DeemanthaGunasekara/Kickbots-Arena/Final set up/Poster/ITM_12_Ohmies.png

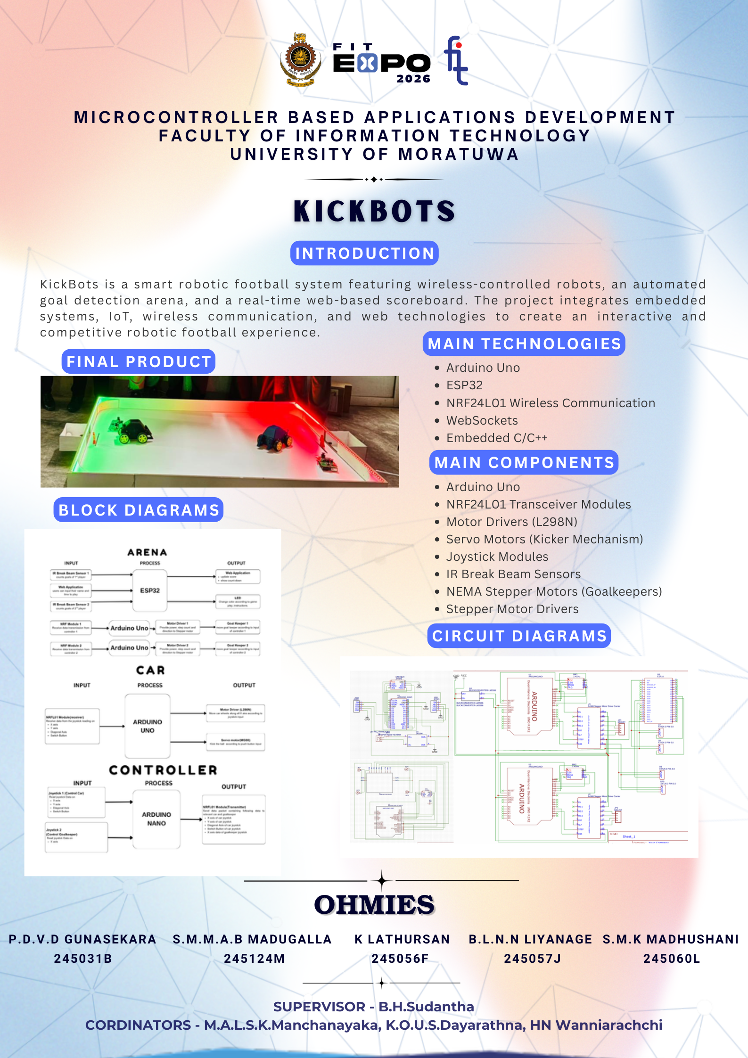
Final set up/Poster/ITM_12_Ohmies.png
