DeemanthaGunasekara/Kickbots-Arena/Screenshot 2025-11-11 154036.png

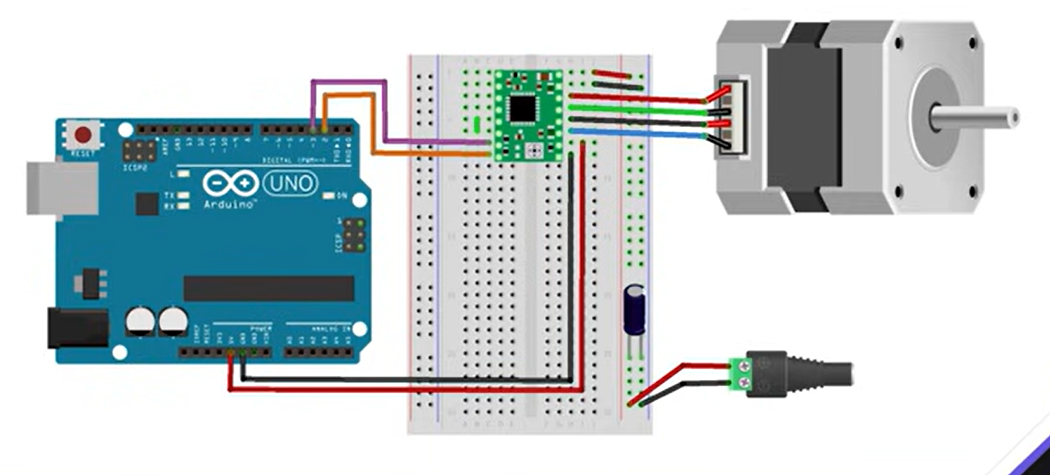
Screenshot 2025-11-11 154036.png
