DeemanthaGunasekara/Kickbots-Arena/README.md

# ⚽ KickBots – Football Robot System

## 📌 Project Description

**KickBots** is a robotics project that combines embedded systems, wireless communication, web technologies, and mechanical design to create a robotic football system. It features two remotely controlled robot cars, a wireless controller, and a smart football arena with automated goal detection and visual and audio feedback.

The robots use Arduino Uno microcontrollers and NRF24L01 wireless modules for communication, while an ESP32 powers the arena's web-based control interface and manages goal detection using IR sensors. LED strips and a buzzer provide feedback when a goal is scored, and a stepper motor-based mechanism supports the goalkeeper system.

The project integrates hardware and software to demonstrate real-time control, wireless communication, and automation in an interactive robotic football environment.

## ✨ Key Features

- 🤖 Two remotely controlled football robots
- 📡 NRF24L01 wireless communication
- 🎮 Joystick-based robot control
- ⚡ Integrated kicker mechanisms
- 🥅 Automated goal detection using IR sensors
- 💡 LED-based goal indicators
- 🔊 Audio feedback using a buzzer
- 🌐 ESP32-powered web interface
- ⚙️ Stepper motor-based goalkeeper mechanism

## 🛠️ Technologies & Components

### Hardware
- Arduino Uno
- ESP32
- Arduino Nano
- NRF24L01 wireless modules
- DC geared motors and motor drivers
- Joystick modules and push buttons
- IR break-beam sensors
- LED strips and piezo buzzer
- Stepper motor and driver
- Battery packs and voltage regulators

### Software & Technologies
- **C/C++** – Microcontroller programming
- **Arduino IDE** – Embedded development
- **HTML, CSS, JavaScript** – Web interface
- **ESP32 Web Server** – Hosting the arena interface
- **Wireless communication** – NRF24L01 modules

## ⚙️ System Overview

1. **Robot Cars:** Arduino Uno boards control the movement and kicker mechanisms of the robots.
2. **Wireless Controller:** Joysticks and buttons send control commands wirelessly through NRF24L01 modules.
3. **Football Arena:** An ESP32 reads IR sensors to detect goals and activates LED strips and a buzzer.
4. **Web Interface:** The ESP32 hosts a website accessible over a local Wi-Fi network for arena monitoring and control.
5. **Goalkeeper Mechanism:** A stepper motor-based system provides goalkeeper movement.

## 🎯 Project Objectives

- Develop remotely controlled football robots.
- Implement reliable wireless communication between the controller and robots.
- Automate goal detection and arena feedback.
- Integrate embedded hardware with a web-based interface.
- Demonstrate practical applications of robotics, IoT, and embedded systems.
- Real-time score tracking and Led changes.

## 🚀 Future Improvements

- Improve wireless communication range and reliability.
- Enhance robot movement and control responsiveness.
- Improve the web interface with additional monitoring features.
- Optimize battery life and power management.
