DeemanthaGunasekara/Kickbots-Arena/Final set up/Proud to share the completion of our IoT.docx

Proud to share the completion of our IoT/Embedded Systems project — KickBots ⚽🤖

KickBots is a wireless embedded robotics system consisting of two Arduino-based football robots, a handheld controller unit, and an arena subsystem for automated goal detection. The robots are controlled in real time using NRF24L01 wireless modules, enabling low-latency communication between the controller and the robots, while IR sensor-based detection is used in the arena to identify goals and trigger scoring events.

The system was developed by a team of 5 members as part of our Information Technology and Management (ITM) degree at the University of Moratuwa. The initial concept and system idea were initiated by me and further developed collaboratively throughout the project lifecycle.

My individual contributions included configuring and programming the Arduino Uno microcontrollers for both robot units, designing and assembling the robot chassis, supporting the integration and testing of the NRF24L01 communication system, and developing and fine-tuning movement control algorithms for omnidirectional motion. I also contributed to core game logic and system-level coordination, assisted in implementing the goalkeeper movement mechanism, and served as the team coordinator overseeing task allocation, testing sessions, and overall project progress.

During development, we faced several real-world engineering challenges including wireless communication instability, motor control inconsistencies under load, and power management issues affecting system stability. Addressing these challenges required iterative testing and debugging, significantly improving our understanding of practical embedded system design and hardware–software integration.

This project became a valuable hands-on experience in embedded systems, robotics, and collaborative engineering design.

A sincere thank you to my teammates [Member 1], [Member 2], [Member 3], and [Member 4] for their dedication and collaboration throughout the project.

We are also deeply grateful to our supervisor, Dr./Mr./Ms. [Supervisor Name], and our instructors [Instructor 1] and [Instructor 2] for their continuous guidance, feedback, and support.
