DeemanthaGunasekara/Kickbots-Arena/pin arrangements/PCB/Document1.pdf

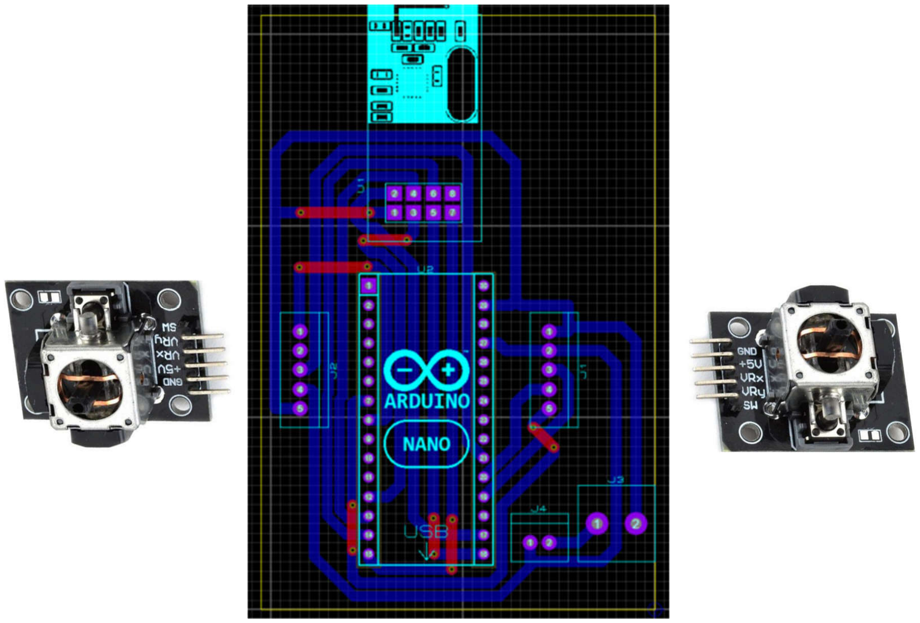
[picture p83: page 1]
