DeemanthaGunasekara/Kickbots-Arena/Final set up/Poster/ESP32.png

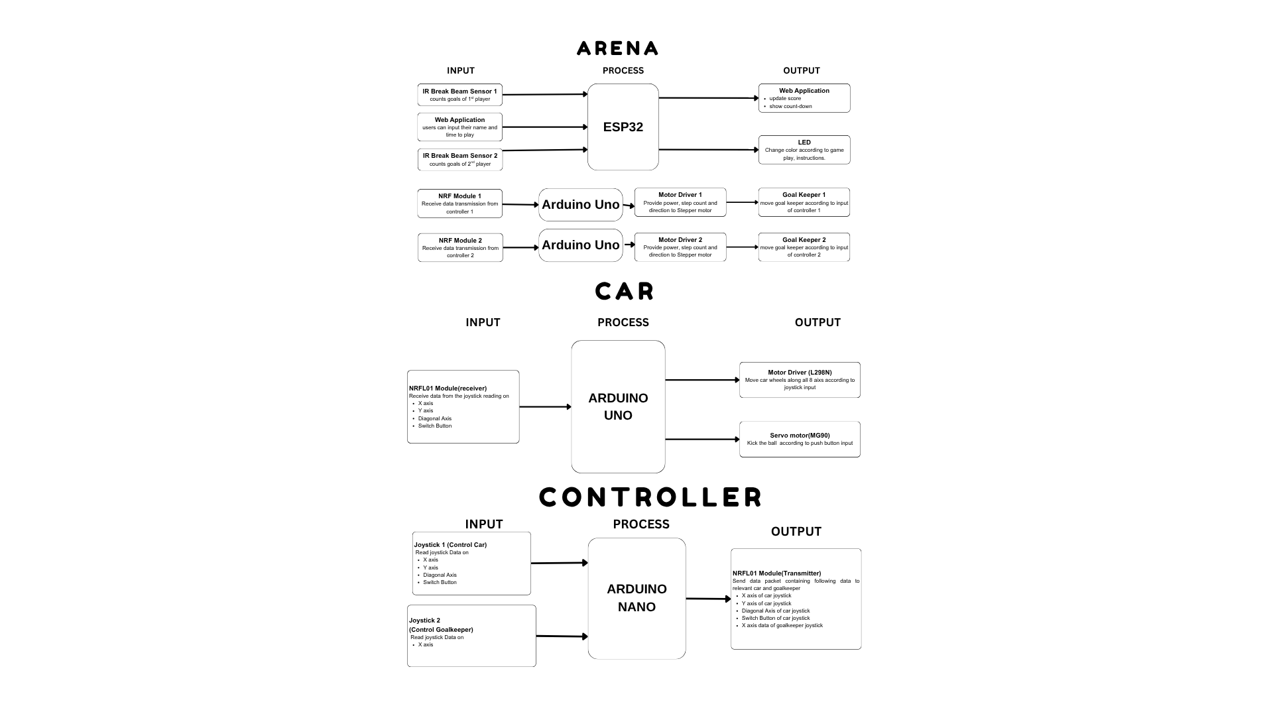
Final set up/Poster/ESP32.png
