DeemanthaGunasekara/Kickbots-Arena/Final set up/Poster/Untitled design (2).png

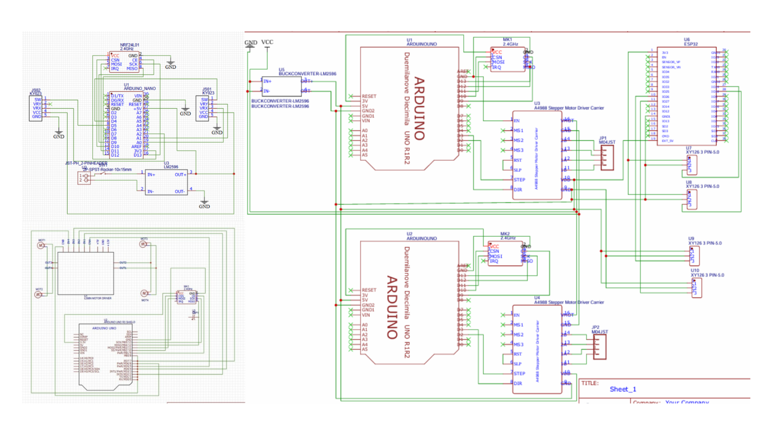
Final set up/Poster/Untitled design (2).png
