DeemanthaGunasekara/Kickbots-Arena/pin arrangements/controller/Screenshot 2026-03-06 151441.png

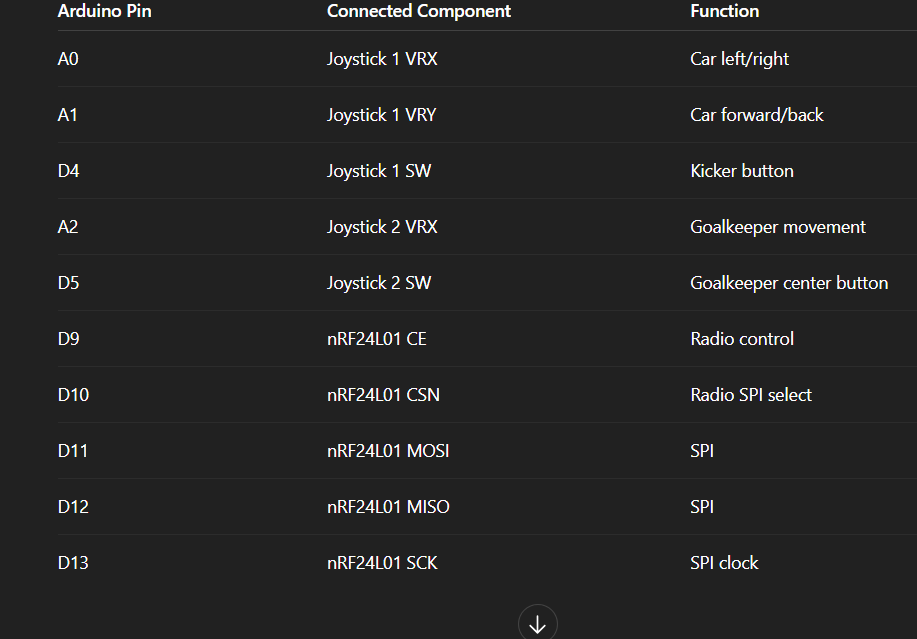
pin arrangements/controller/Screenshot 2026-03-06 151441.png
