DeemanthaGunasekara/Kickbots-Arena/pin arrangements/controller/Screenshot 2026-03-06 151446.png

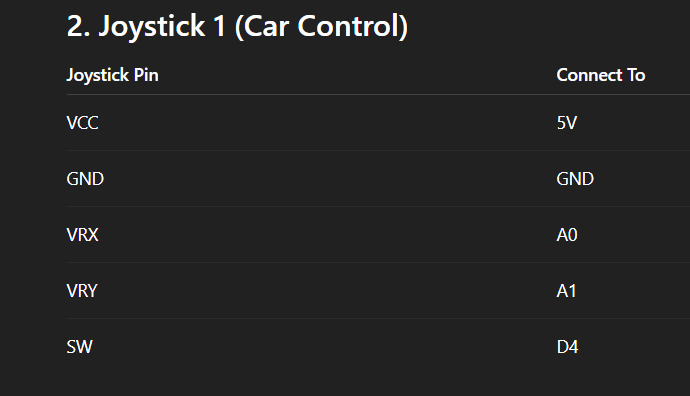
pin arrangements/controller/Screenshot 2026-03-06 151446.png
