DeemanthaGunasekara/Kickbots-Arena/pin arrangements/PCB @/WhatsApp Image 2026-05-29 at 10.33.38 (1).jpeg

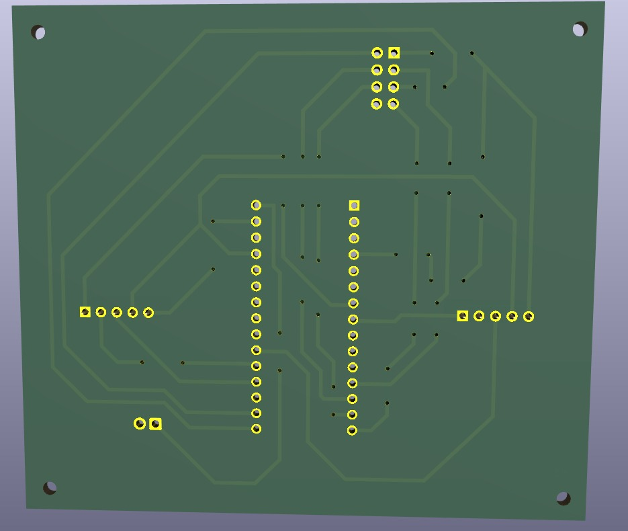
pin arrangements/PCB @/WhatsApp Image 2026-05-29 at 10.33.38 (1).jpeg
