DeemanthaGunasekara/Kickbots-Arena/pin arrangements/PCB/WhatsApp Image 2026-03-24 at 21.07.42.jpeg

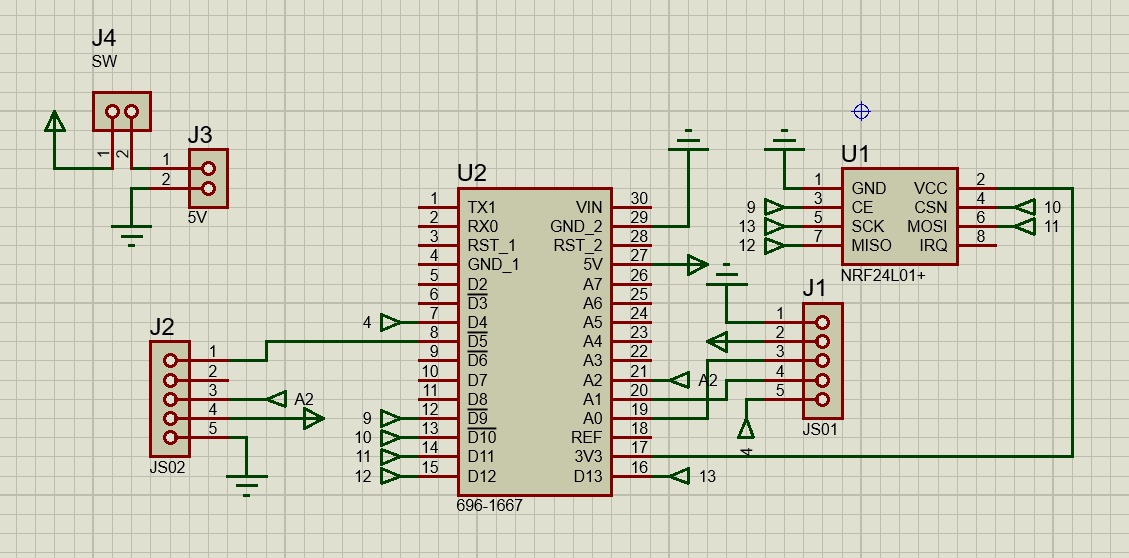
pin arrangements/PCB/WhatsApp Image 2026-03-24 at 21.07.42.jpeg
