DeemanthaGunasekara/Kickbots-Arena/Screenshot 2025-11-01 162124.png

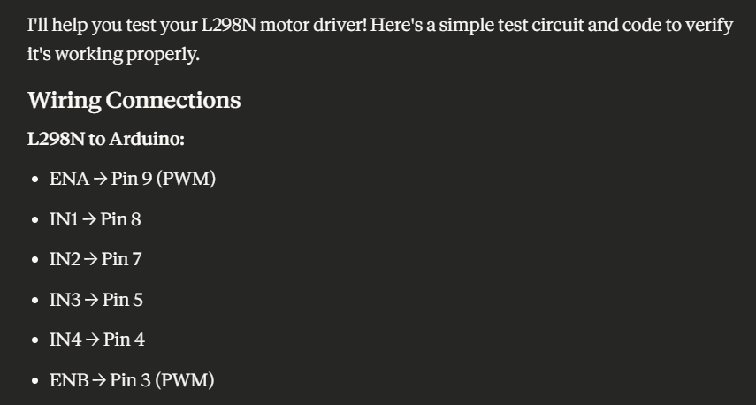
Screenshot 2025-11-01 162124.png
