DeemanthaGunasekara/Kickbots-Arena/Screenshot 2025-11-04 143917.png

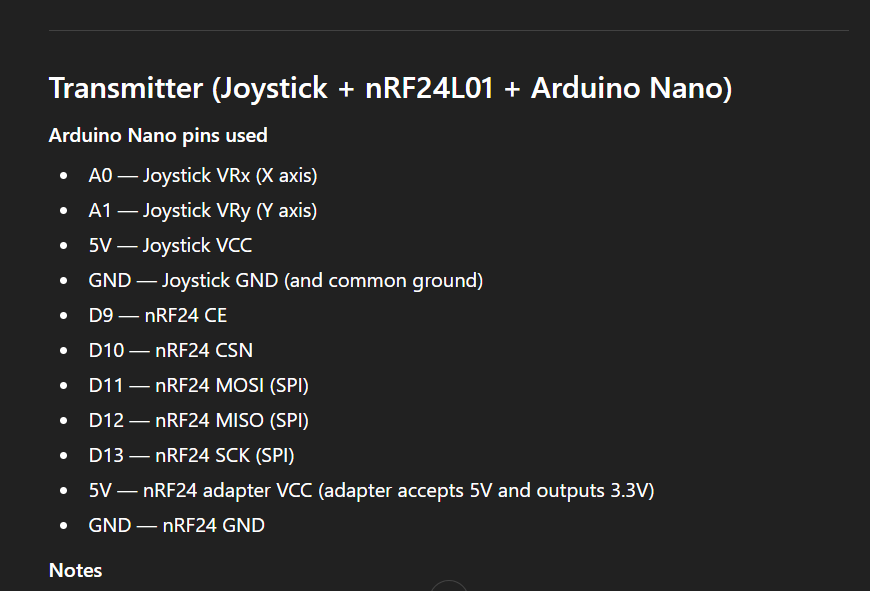
Screenshot 2025-11-04 143917.png
