DeemanthaGunasekara/Kickbots-Arena/Screenshot 2025-11-04 143926.png

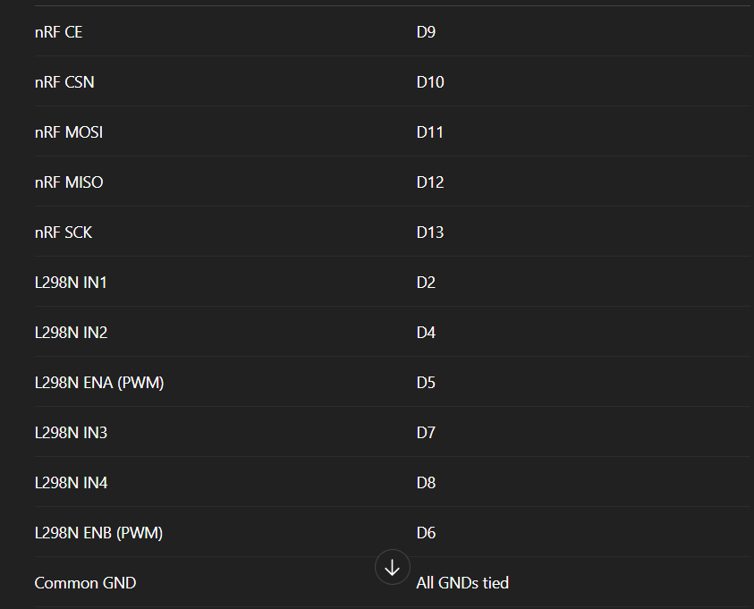
Screenshot 2025-11-04 143926.png
