DeemanthaGunasekara/Kickbots-Arena/Screenshot 2025-11-08 163941.png

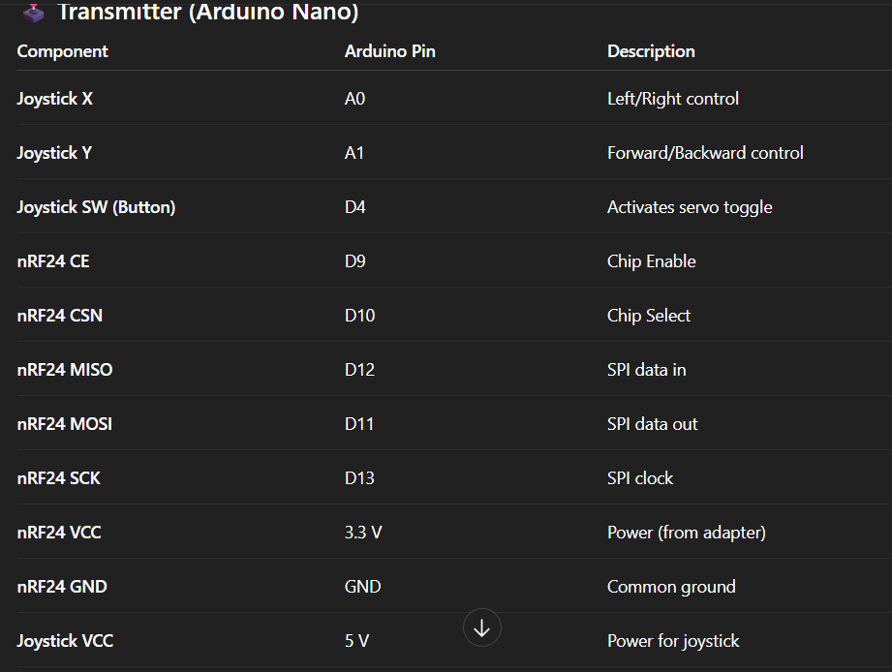
Screenshot 2025-11-08 163941.png
