DeemanthaGunasekara/Kickbots-Arena/Screenshot 2025-11-08 163957.png

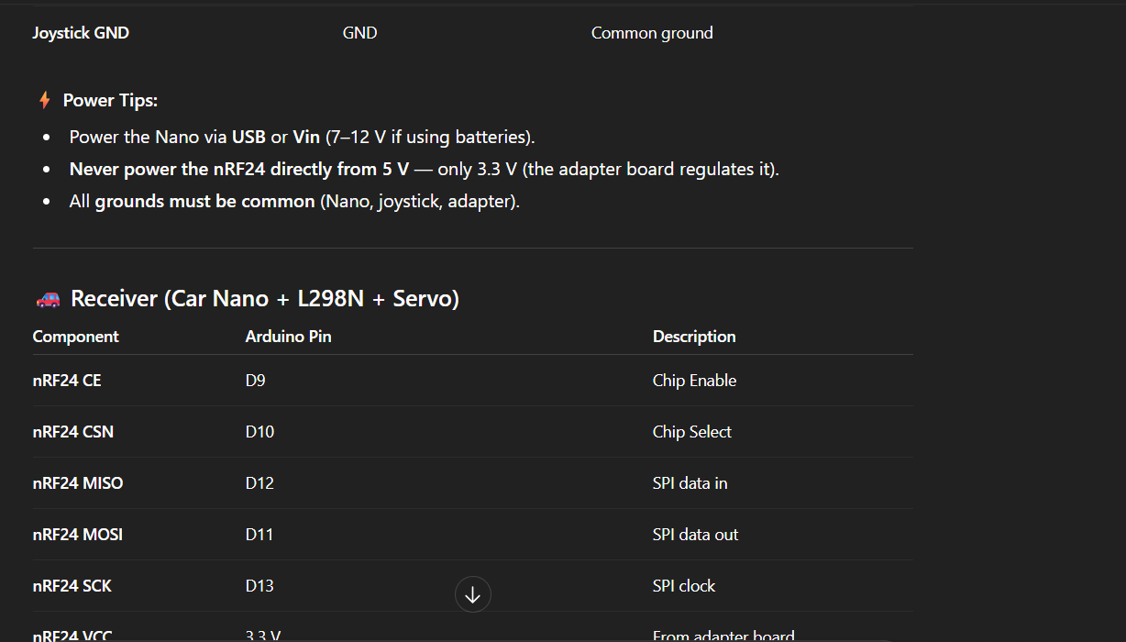
Screenshot 2025-11-08 163957.png
