DeemanthaGunasekara/Kickbots-Arena/Screenshot 2025-11-08 164010.png

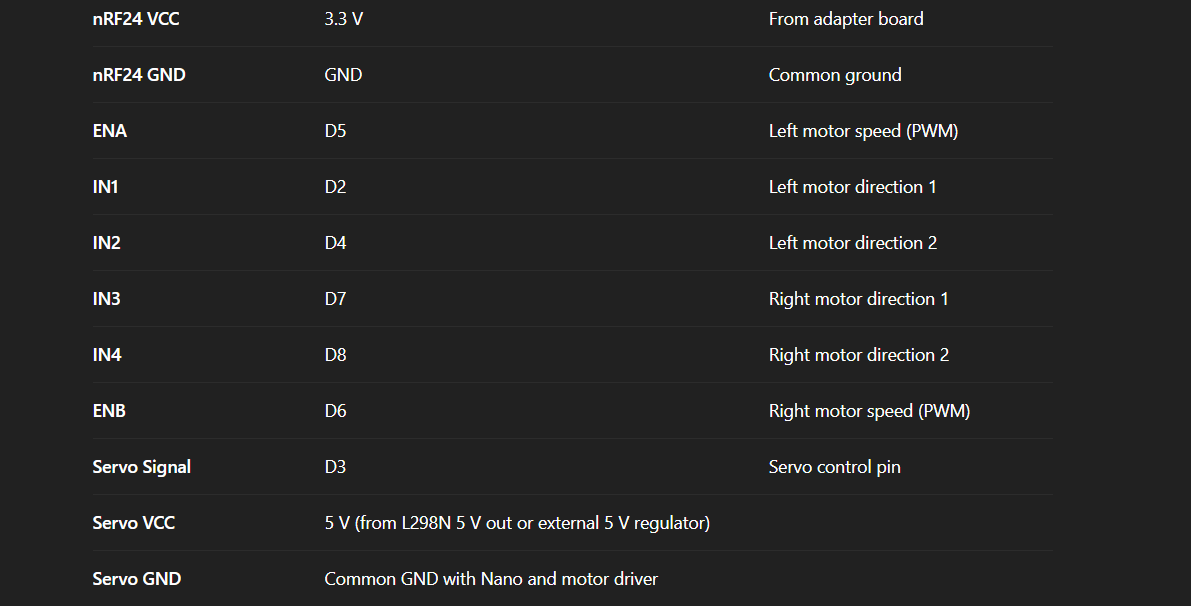
Screenshot 2025-11-08 164010.png
