DeemanthaGunasekara/Kickbots-Arena/Screenshot 2025-11-10 094230.png

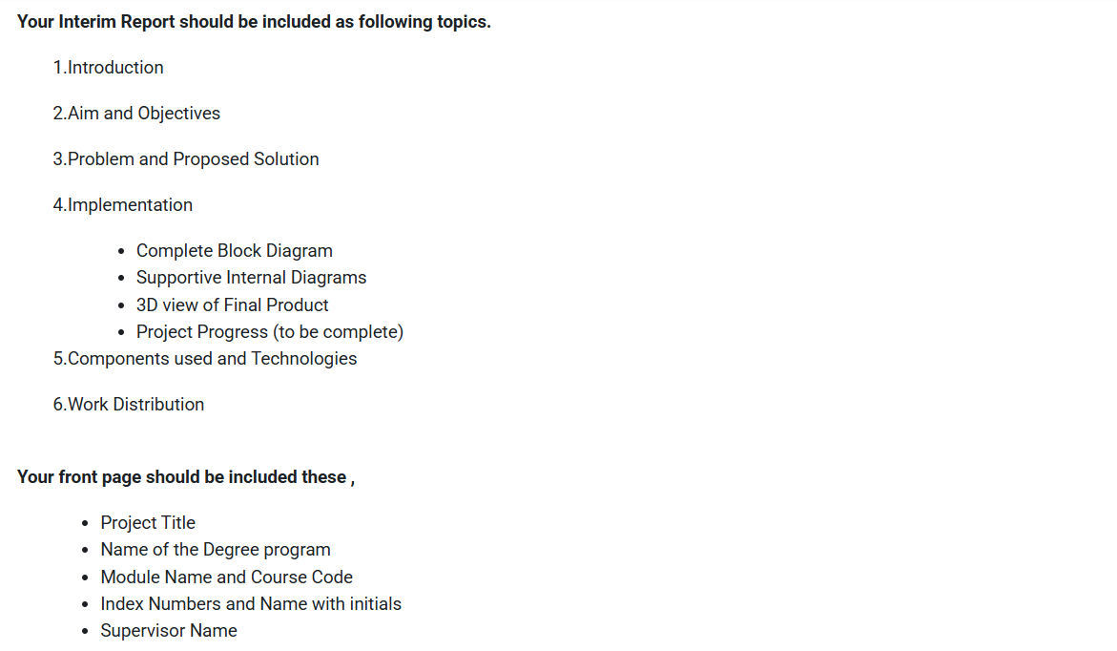
Screenshot 2025-11-10 094230.png
