DeemanthaGunasekara/Kickbots-Arena/Screenshot 2025-11-10 094244.png

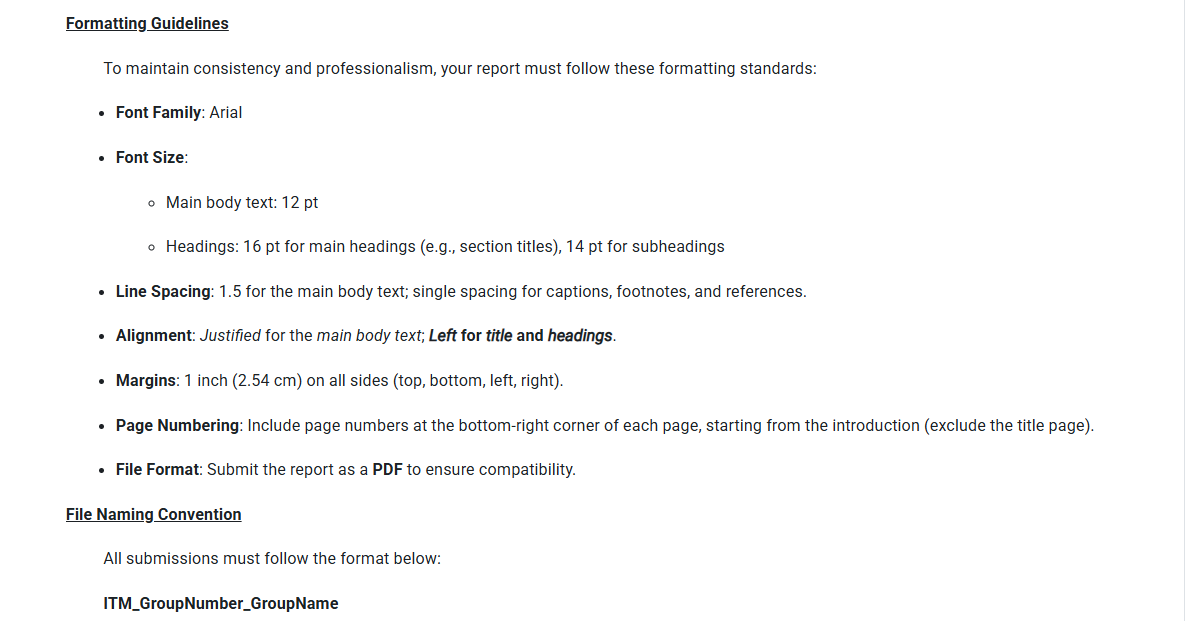
Screenshot 2025-11-10 094244.png
