DeemanthaGunasekara/Kickbots-Arena/Screenshot 2025-11-10 100208.png

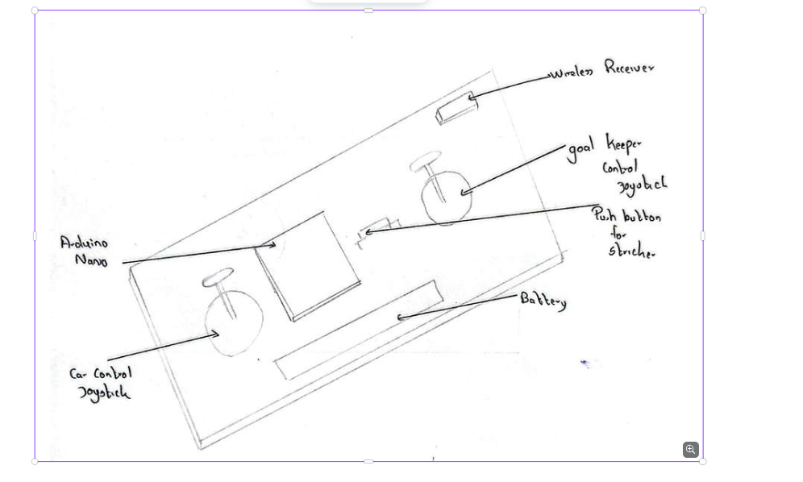
Screenshot 2025-11-10 100208.png
