DeemanthaGunasekara/Kickbots-Arena/Screenshot 2025-11-11 143157.png

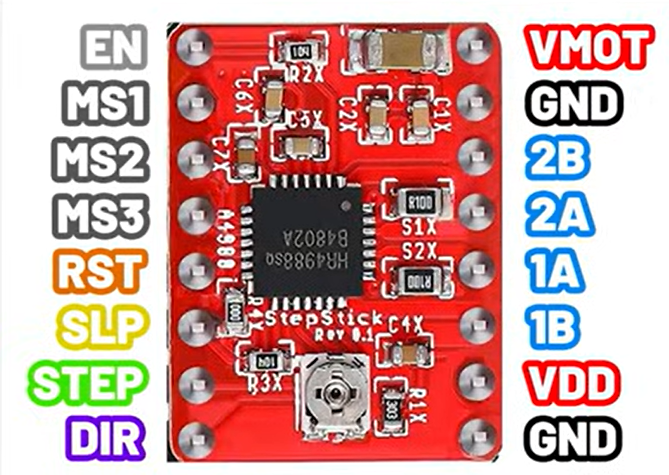
Screenshot 2025-11-11 143157.png
