DeemanthaGunasekara/Kickbots-Arena/Screenshot 2025-11-17 170926.png

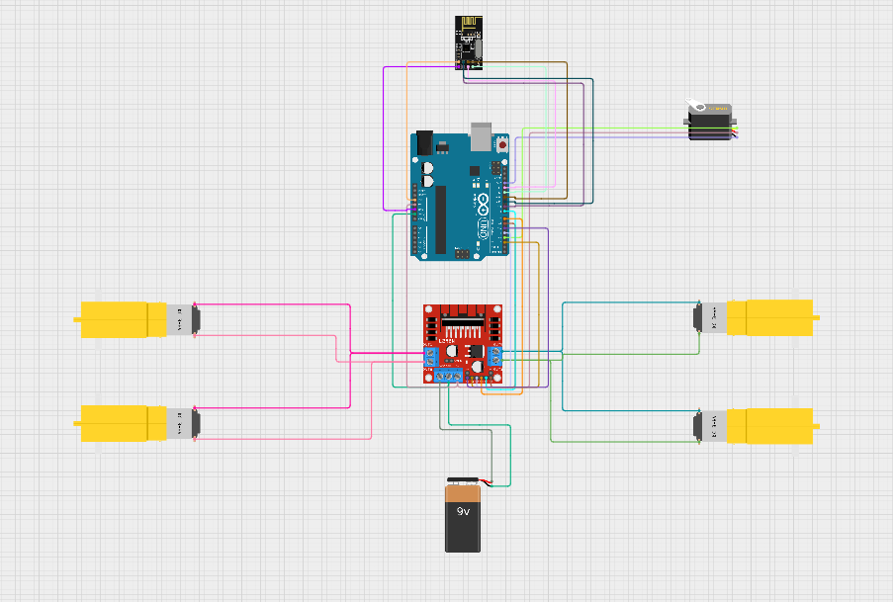
Screenshot 2025-11-17 170926.png
