DeemanthaGunasekara/Kickbots-Arena/Screenshot 2025-11-17 171112.png

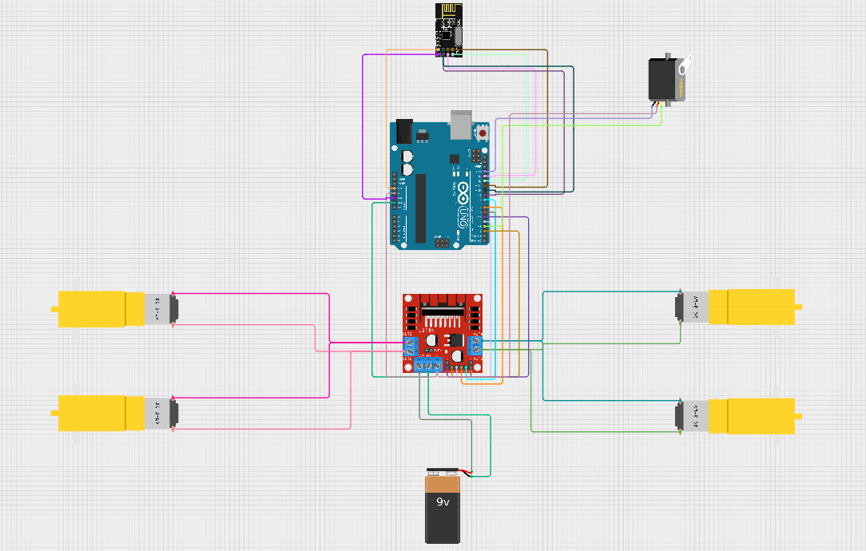
Screenshot 2025-11-17 171112.png
