DeemanthaGunasekara/Kickbots-Arena/Final set up/budget.xlsx

component | qty | Indivival price | Total
Geared Motors | 8 | 130 | 1040
arduino uno | 4 | 2000 | 8000
Nrf | 6 | 350 | 2100
L298N motor driver | 2 | 420 | 840
Switch | 4 | 50 | 200
Car 3D | 2 | 6000 | 12000
Ardino nano | 2 | 1300 | 2600
Joystick Module | 4 | 420 | 1680
LM2596 Buck converter | 4 | 150 | 600
Battery 3.7v | 10 | 500 | 5000
PCB | 2 | _ | 9000
NEMA 17 Stepper motor | 2 | 2620 | 5240
A4988 stepper motor driver | 2 | 280 | 520
ESP 32 | 1 | 1500 | 1500
Power supply Unit | 1 | 1900 | 1900
Goal keeper 3D | 2 | 900 | 1800
Rail(Extrusion bar, gantry plate& etc | 2 | 7000 | 14000
Melamaine board & cutting | _ | _ | 12000
Total Budget |  |  | 80020
