DeemanthaGunasekara/Kickbots-Arena/pin arrangements/PCB/5538/Gerber_03.09_PCB_New-Project-2.28_2026-03-22 (1)/How-to-order-PCB.txt

How to Order PCB

Please refer to:
https://docs.easyeda.com/en/PCB/Order-PCB
