DeemanthaGunasekara/Kickbots-Arena/initial component testing tests/basic setup - progress/failed 2 golie work with different transmitterrs/Screenshot 2026-03-01 201830.png

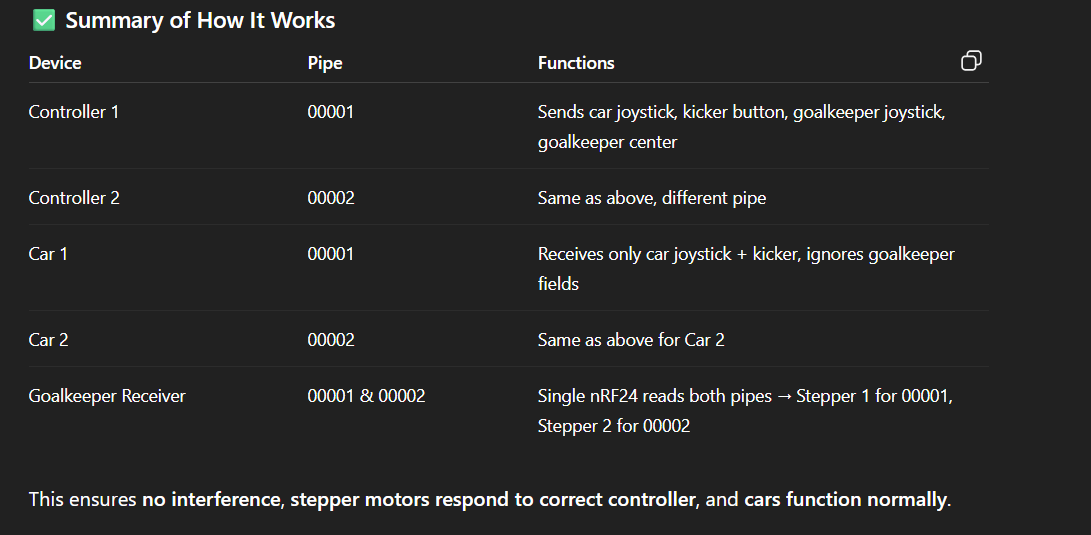
initial component testing tests/basic setup - progress/failed 2 golie work with different transmitterrs/Screenshot 2026-03-01 201830.png
