DeemanthaGunasekara/Kickbots-Arena/Final set up/Report/Schematic_Arena-schematic_2026-06-12 (2).pdf

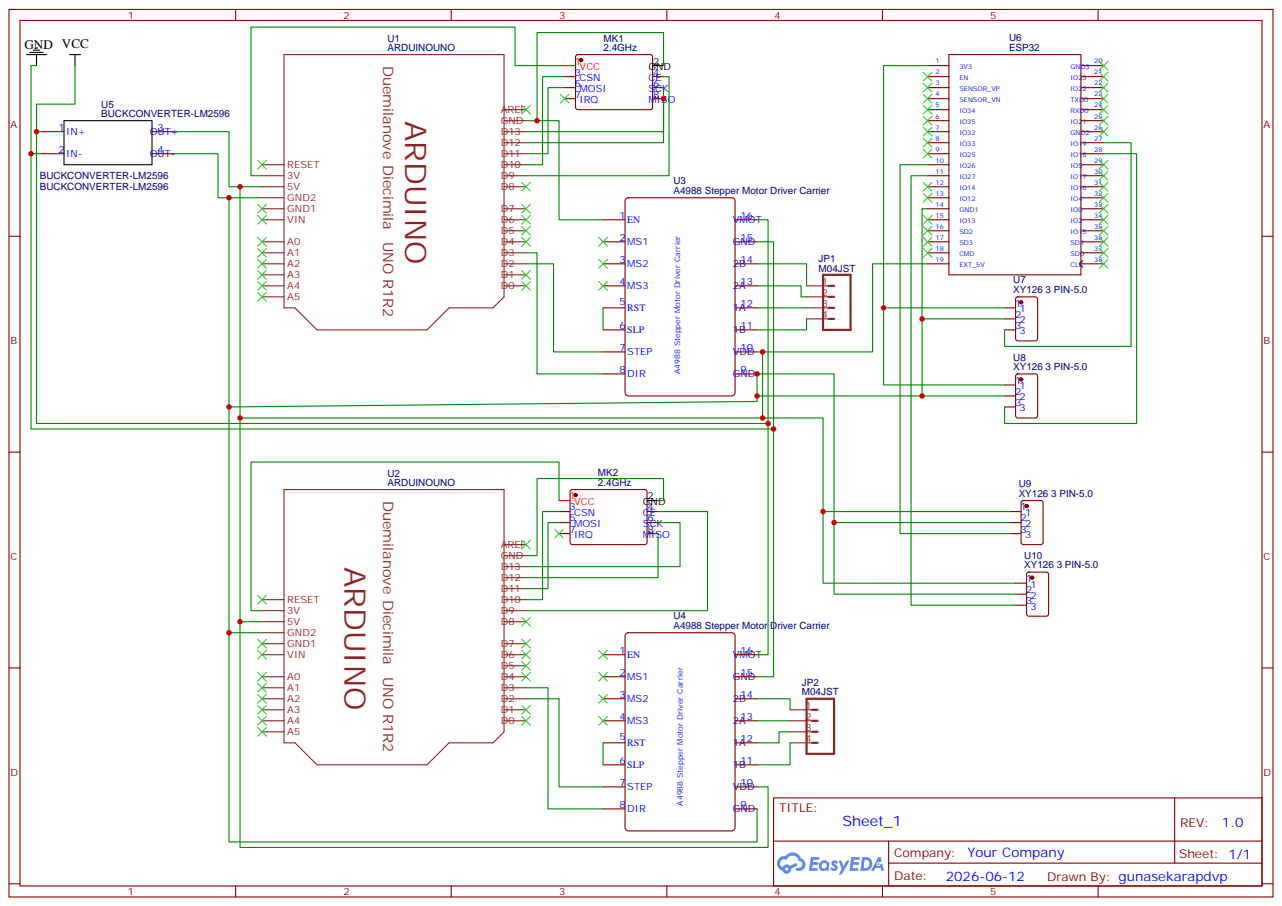
[picture p108: page 1]

A4988 Stepper Motor Driver Carrier
