DeemanthaGunasekara/Kickbots-Arena/pin arrangements/PCB @/solder.pdf

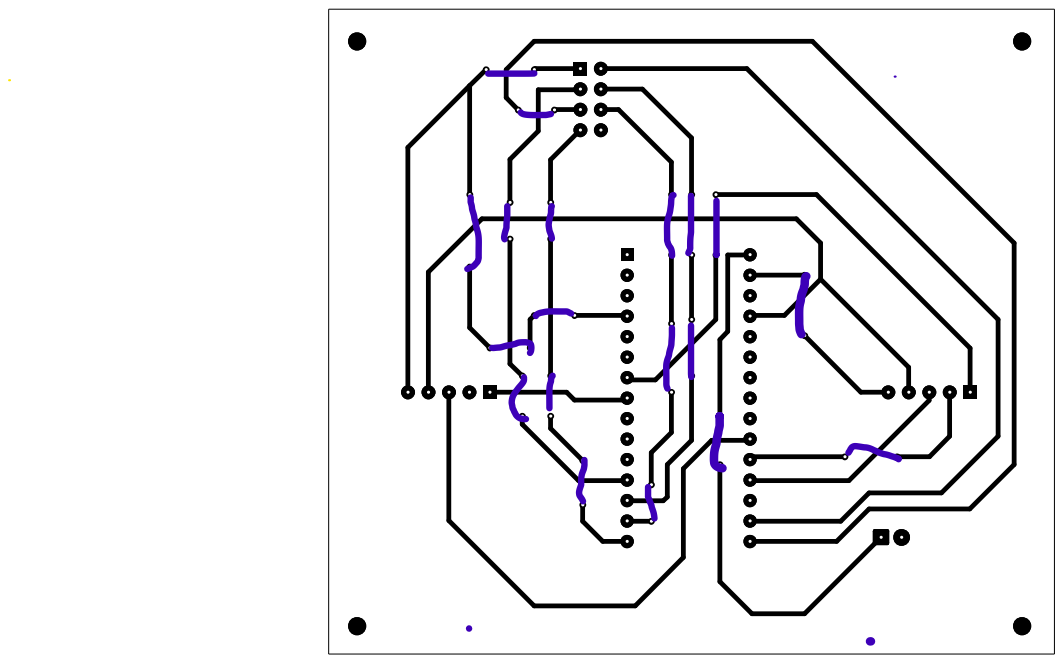
[picture p109: page 1]
