DeemanthaGunasekara/Kickbots-Arena/Final set up/PCB/all layers in one.pdf

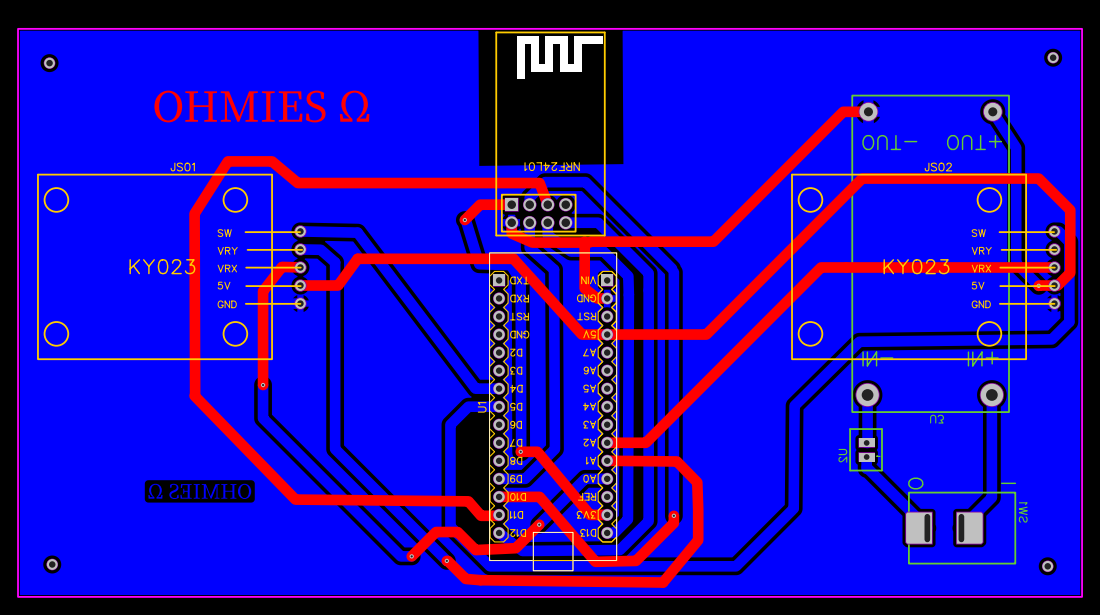
[picture p110: page 1]
