DeemanthaGunasekara/Kickbots-Arena/Final set up/PCB/ITM_12_Ohmies.pdf

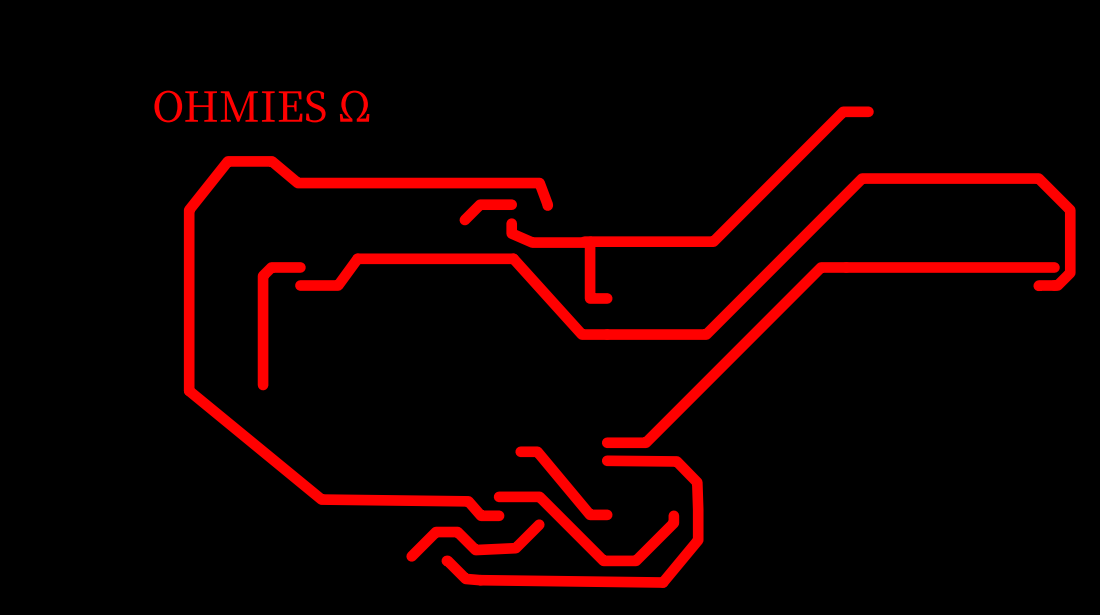
[picture p111: page 2]

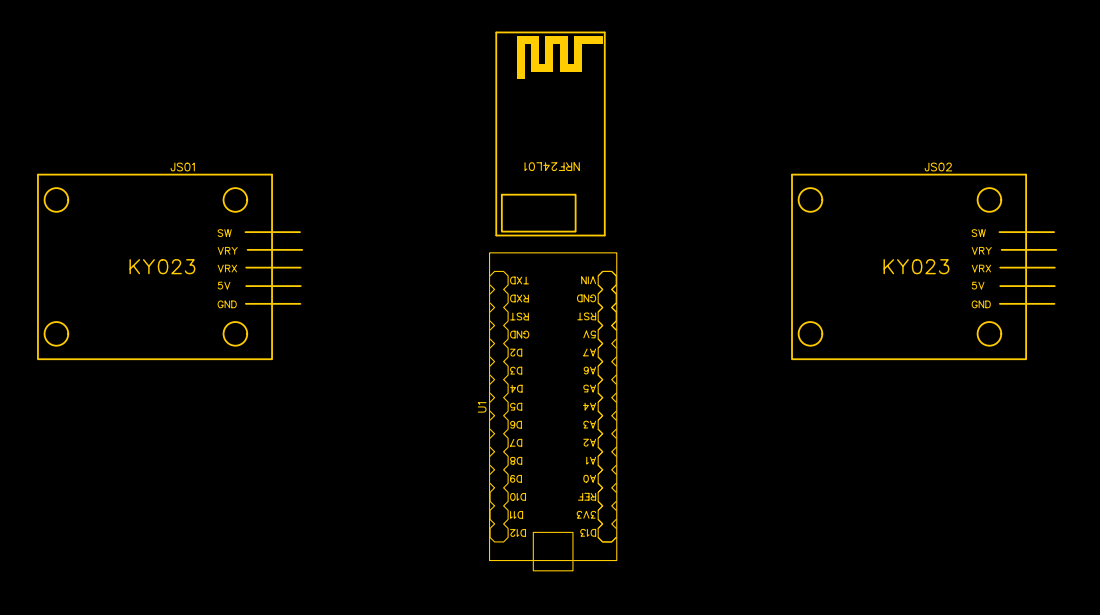
[picture p112: page 3]

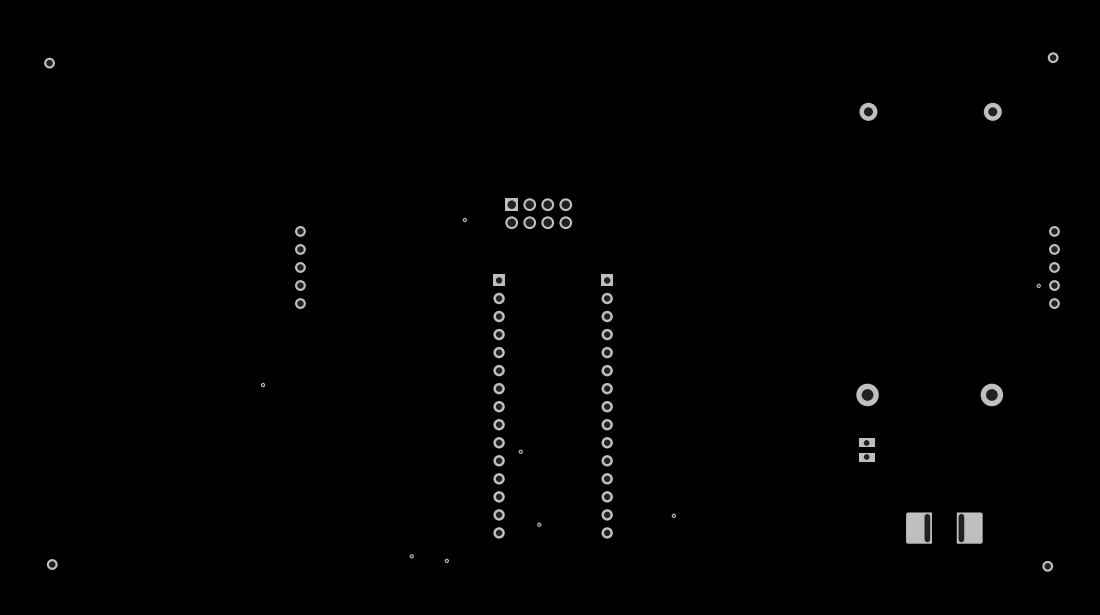
[picture p113: page 5]
