DeemanthaGunasekara/Kickbots-Arena/pin arrangements/PCB @/bottom.pdf

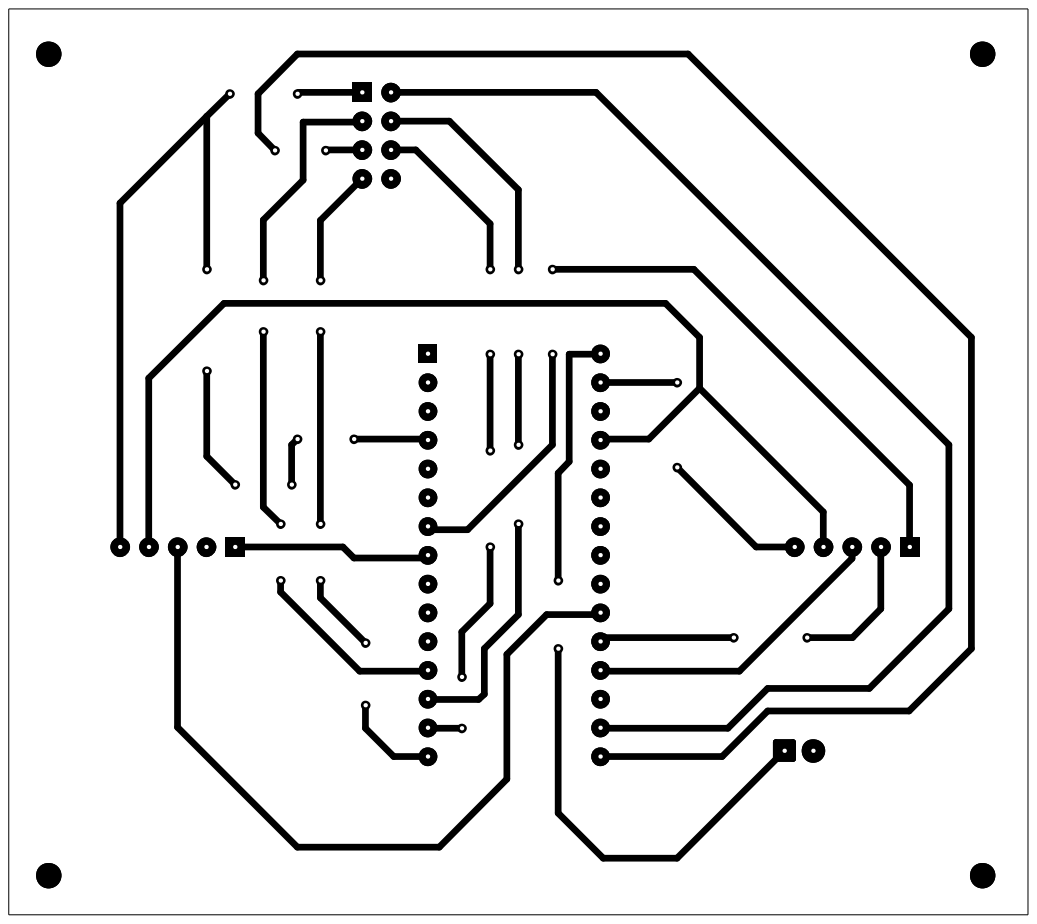
[picture p114: page 1]
