DeemanthaGunasekara/Kickbots-Arena/pin arrangements/PCB @/top silk.pdf

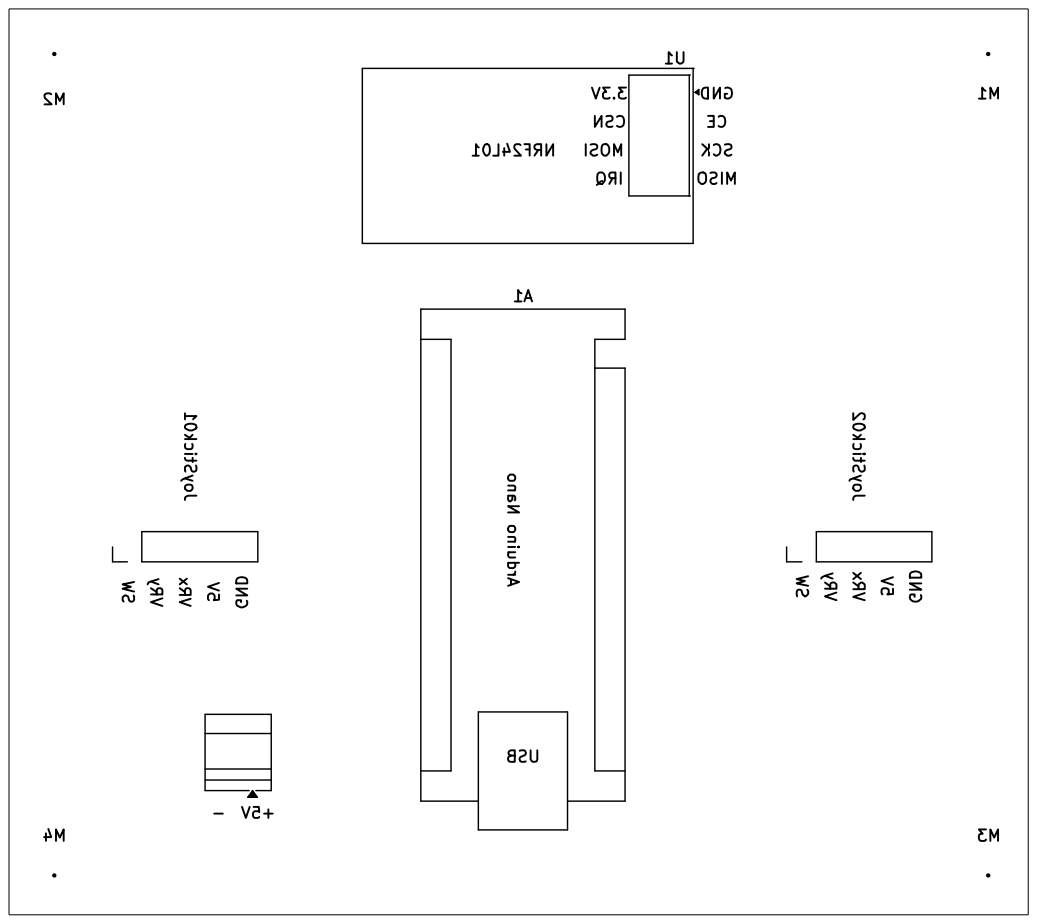
[picture p115: page 1]
