DeemanthaGunasekara/Kickbots-Arena/(list of files, drawings)

Other design files:
Final set up/PCB/SCH_FINAL-Kickbots-joystick-2026-06-17.json
pin arrangements/PCB/5538/New Project.pdsprj
pin arrangements/PCB/5538/Project Backups/New Project [20260323, 22-02-29].pdsprj
pin arrangements/PCB/5538/Project Backups/New Project [20260323, 22-02-59].pdsprj
pin arrangements/PCB/5538/Project Backups/New Project [20260323, 22-25-56].pdsprj
pin arrangements/PCB/5538/Project Backups/New Project [20260323, 22-29-18].pdsprj
pin arrangements/PCB/5538/Project Backups/New Project [20260324, 00-03-57].pdsprj
pin arrangements/PCB/5538/Project Backups/New Project [20260324, 00-04-01].pdsprj
pin arrangements/PCB/5538/Project Backups/New Project [20260324, 20-31-45].pdsprj
pin arrangements/PCB/5538/Project Backups/New Project [20260324, 21-05-57].pdsprj
pin arrangements/PCB/5538/Project Backups/New Project [20260324, 21-07-49].pdsprj
pin arrangements/PCB/5538/Project Backups/New Project [20260329, 19-11-30].pdsprj
