DeemanthaGunasekara/Kickbots-Arena/initial component testing tests/motordriver test 1/test 1/test 1.ino

int motor1pin1 = 8;
int motor1pin2 = 7;

int motor2pin1 = 5;
int   motor2pin2 = 4;

void setup() {
  // put your setup code here, to run once:
   pinMode(motor1pin1, OUTPUT);
  pinMode(motor1pin2, OUTPUT);
  pinMode(motor2pin1,   OUTPUT);
  pinMode(motor2pin2, OUTPUT);

  //(Optional)
  pinMode(9,   OUTPUT); 
  pinMode(3, OUTPUT);
  //(Optional)
}
void loop() {
  //  digitalWrite(motor1pin1,   HIGH);
  //  delay(1000);
  //  digitalWrite(motor1pin1,   LOW);
  //  delay(1000);

  // digitalWrite(motor1pin2, HIGH);
  // delay(1000);
  //  digitalWrite(motor1pin2,   LOW);
  //  delay(1000);

  // digitalWrite(motor2pin1, HIGH);
  // delay(1000);
  //  digitalWrite(motor2pin1,   LOW);
  //  delay(1000);

  //  digitalWrite(motor2pin2, HIGH);
  //  delay(1000);
  //  digitalWrite(motor2pin2,   LOW);
  //  delay(1000);

  //  digitalWrite(9, HIGH);
  //  delay(1000);
  //  digitalWrite(9,LOW);
  //  delay(1000);

  //  digitalWrite(3, HIGH);
  //  delay(1000);
  //  digitalWrite(3,LOW);
  //  delay(1000);
  

}
