DeemanthaGunasekara/Kickbots-Arena/(commit log)

2026-02-28 Create Motor driver testing.
2026-02-28 Add files via upload
    in this we tested the motor driver , motors to find the directions each motor should move , the speed and other
    ,motor driver was directly connected to the arduino and no data transmission happened.
2026-02-28 Rename test 1.ino to Motor Driver test 1.ino
2026-02-28 Rename test 2.ino to Motor Driver test 2.ino
2026-02-28 Rename test 3.ino to Motor Driver test 3.ino
2026-08-07 first yeat microcontroller project
    [Budget.xlsx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]
